Kerbal12/DatumLogic/Data Logger Report.pdf

# ESP32-Based Environmental Data Logger with IoT Control and Cloud Backup

## REPORT

Prepared by: Abhijith R, Adnan Nizam, Jensen Jose Sajan Date: 10/07/25

## 1. Abstract

This project presents an ESP32-based environmental data logger capable of real-time monitoring, automated control, and IoT-enabled remote access. It supports measurement of temperature, humidity, soil moisture, pressure, and light intensity and stores this data locally and on the cloud. The system integrates with Google Sheets and the Blynk platform for visualisation and remote control. Dual connectivity modes, utilising both WiFi and GSM, ensure continuous operation. Designed with scalability and reliability in mind, this device is suited for agriculture, research, and smart environment applications.

## 2. Introduction

The report provides the design and development of a real-time monitoring and control ESP32-based environmental data logger for environmental parameters. The system is suitable for use in agriculture, horticulture, and environmental studies and has automated control, robust local and cloud data logging, and complete remote access through IoT integration.

Objectives

- Measure temperature, humidity, soil moisture, atmospheric pressure, and light intensity.
- Record environmental data locally on a microSD card.
- Transfer sensor data to Google Sheets over the internet.
- Control connected devices automatically (e.g., pump, grow light) using sensor data.
- Allow remote monitoring and control through the Blynk IoT platform.
- Offer network redundancy by supporting WiFi and GSM-based data transmission.

System Overview

The data logger utilises the ESP32 microcontroller to acquire sensor readings at specified intervals. Data is shown locally, saved to an SD card, and uploaded to the cloud via WiFi or GSM (SIM800L). A real-time clock module stamps each reading. Both manual and automatic control of actuators through relay modules are supported by the system. Threshold values and operating modes can be set through the Blynk mobile app. The hardware assembly is enclosed in a custom 3D-printed case, designed for durability, sensor accessibility, and protection in semi-outdoor environments.

## 3. Project and System Details

### 3.1 Sensor Integration

- Temperature and Humidity Monitoring (DHT22)
- Soil Moisture Detection (Analog Sensor)
- Atmospheric Pressure Measurement (BMP180)
- Light Intensity Measurement (BH1750)

### 3.2 Data Logging

- Data is stored in CSV format on a microSD card.
- Cloud logging is performed via Google Sheets using HTTPS.
- Logging intervals are user-adjustable via the Blynk app.

Cloud logging in google sheets

### 3.3 Automated Control

- Automatic pump operation when soil moisture falls below a user-configured threshold.
- Grow light operations based on light intensity.
- Thresholds and automation modes are remotely configurable.
- Both relays have manual override.

### 3.4 Connectivity

- WiFi is the main network interface.
- GSM (SIM800L) as a failover if WiFi is not available.

- WiFiManager for dynamic WiFi credential configuration without code change.

### 3.5 User Interface

- The OLED display cycles through system status and sensor readings.
- Two buttons offer UI navigation and system reset.
- LED indicators indicate operation and connectivity status.

### 3.6 Software Architecture

The software is written based on the Arduino platform. It has a modular design for maintainability and readability. The most important tasks are allocated logically and make use of FreeRTOS where necessary for simultaneous/parallel execution.

### 3.6.1 Functional Modules

- Sensor reading and verification
- OLED display refresh and navigation
- SD card logging
- WiFi and GSM communication
- Blynk IoT interface
- Relay control logic
- Buck converter
- REAL Time Clock for time stamping (DS3231)

### 3.6.2 Cloud Integration

- Google Sheets receives data through HTTP POST requests via a Google Apps Script endpoint.
- The format consists of timestamp, temperature, humidity, soil moisture, light intensity, and pressure.
- Data is transmitted at configurable intervals with fallback logic to retry on failure.

### 3.7 Blynk IoT Platform

Real-time access to all sensor data and control commands for relays is provided through the Blynk app. The features include:

- Displaying live readings
- Specifying moisture and lux thresholds
- Enabling/disabling automation
- Toggling relays manually
- Adjusting logging intervals
- Forcing manual data uploads

### 3.8 Backup and Fail-Safes

For added system reliability, there are a number of fail-safes implemented:

### 3.8.1 SD Card Logging Backup

- When primary logging to the main CSV file is impossible, data is diverted to a temporary file on the same SD card.
- Logging resumes to the main file as soon as the problem is corrected.

### 3.8.2 Network Fallback

- The system tries to send data over WiFi initially.
- In case of failure to send via WiFi after a number of attempts, GSM is automatically set up and utilised to send data.

### 3.8.3 Logging Continuity

- Even if both cloud methods are not available, local logging proceeds uninterrupted.
- This prevents data loss even in poor network conditions.

### 3.8.4 System Recovery

- System or WiFi credentials can be reset with the help of buttons to reconfigure.
- All the errors and fallbacks are non-blocking and enable uninterrupted operation.

### 3.9 Operational Workflow

Startup:

- Initialises sensors, SD card, display, and connectivity modules.
- RTC time is verified and synchronised as required.

Loop Operation:

- Read all the sensors at the specified interval.
- Updates OLED display based on button interaction.
- Applies automation logic to control relays.
- Logs data to SD card.
- Sends data to Google Sheets via WiFi or GSM.
- Updates values to Blynk.

Manual Functions:

- Relay control and threshold changes via Blynk.
- Force logging and reset via button combinations.

### 3.10 Applications

- Precision Agriculture
- Greenhouse Automation
- Weather Station
- Remote Environmental Monitoring
- Educational and Research Projects

### 3.11 Images

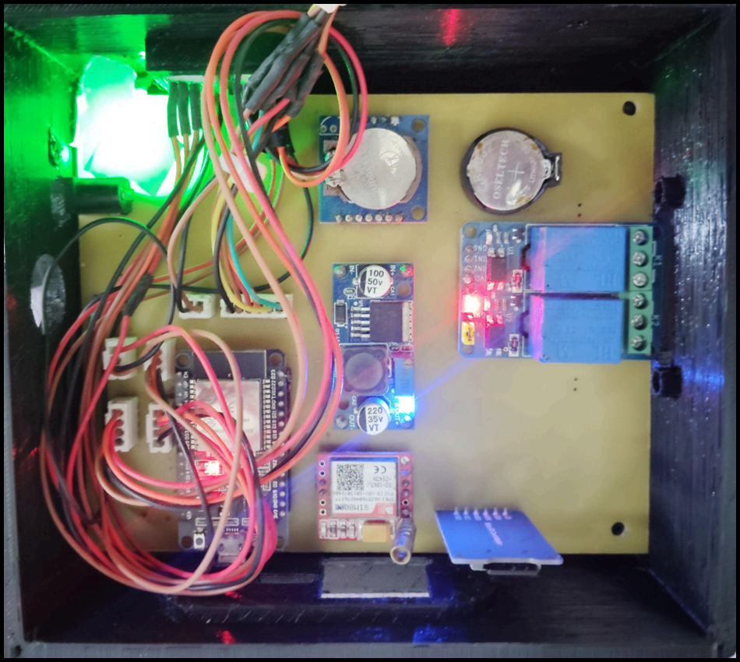
[picture p1: figure]

MAIN PCB

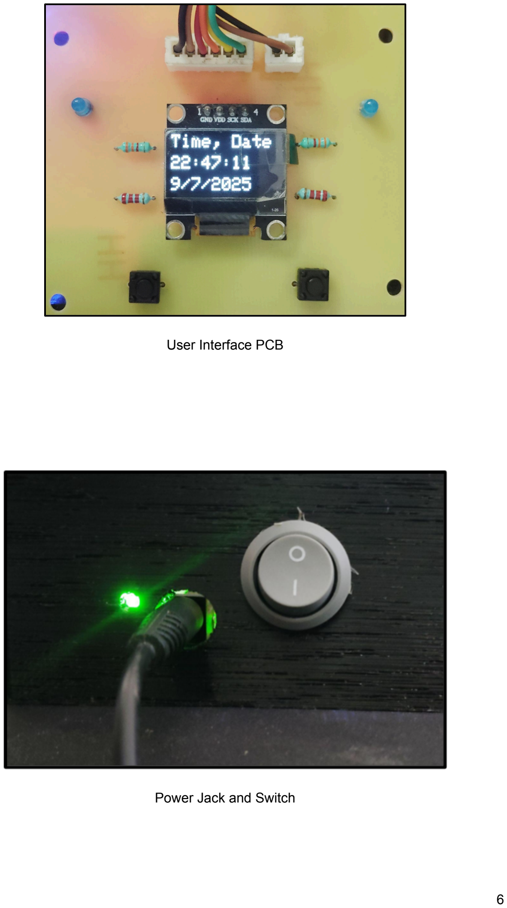
[picture p2: page 6]

User Interface PCB

Power Jack and Switch

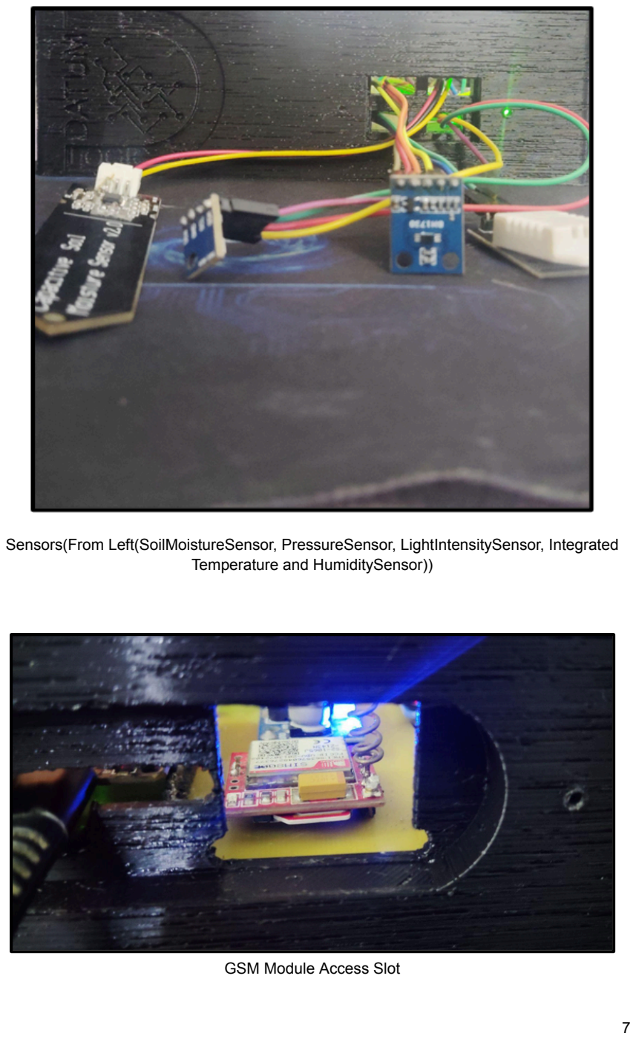
[picture p3: page 7]

Sensors(From Left(SoilMoistureSensor, PressureSensor, LightIntensitySensor, Integrated Temperature and HumiditySensor))

GSM Module Access Slot

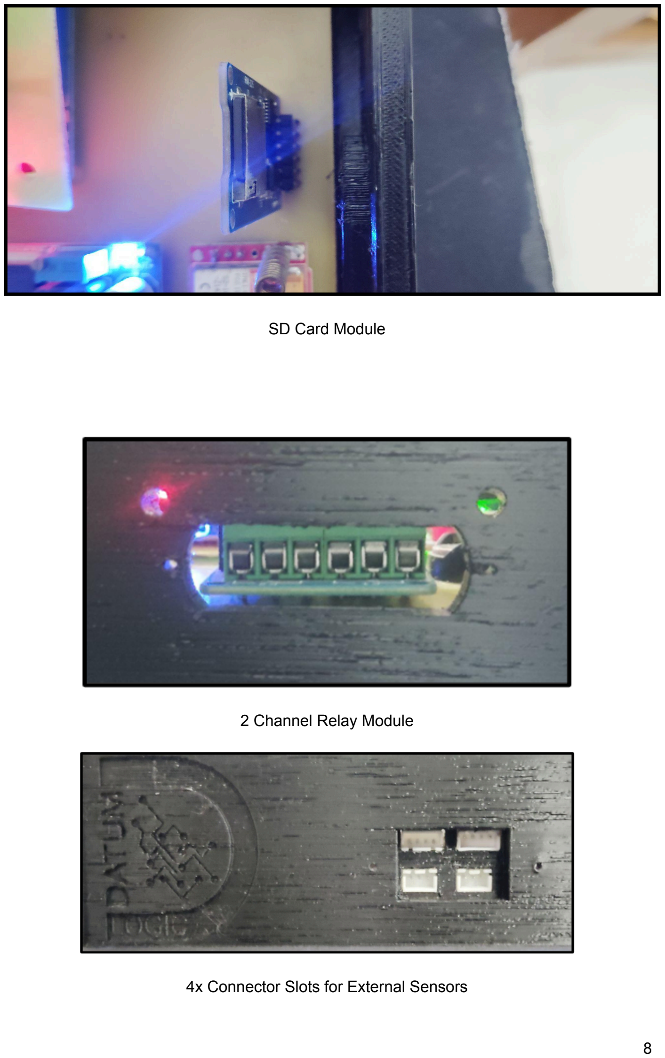
[picture p4: page 8]

SD Card Module

2 Channel Relay Module

4x Connector Slots for External Sensors

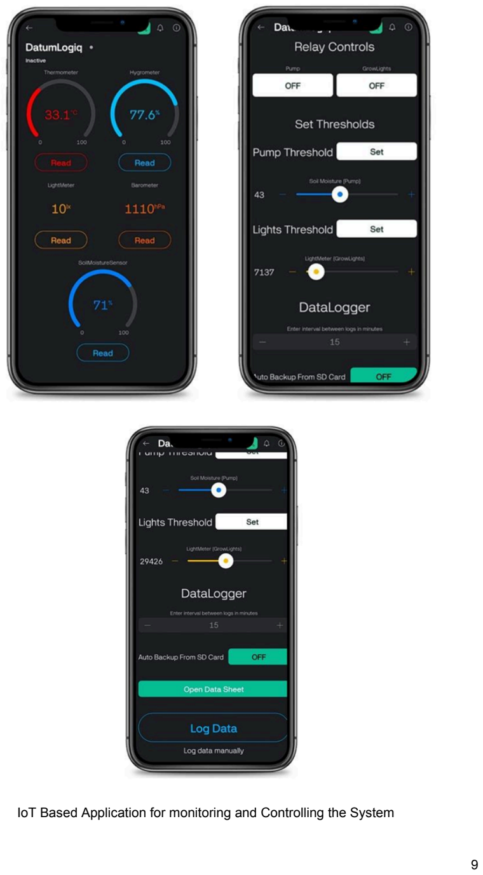
[picture p5: page 9]

IoT Based Application for monitoring and Controlling the System

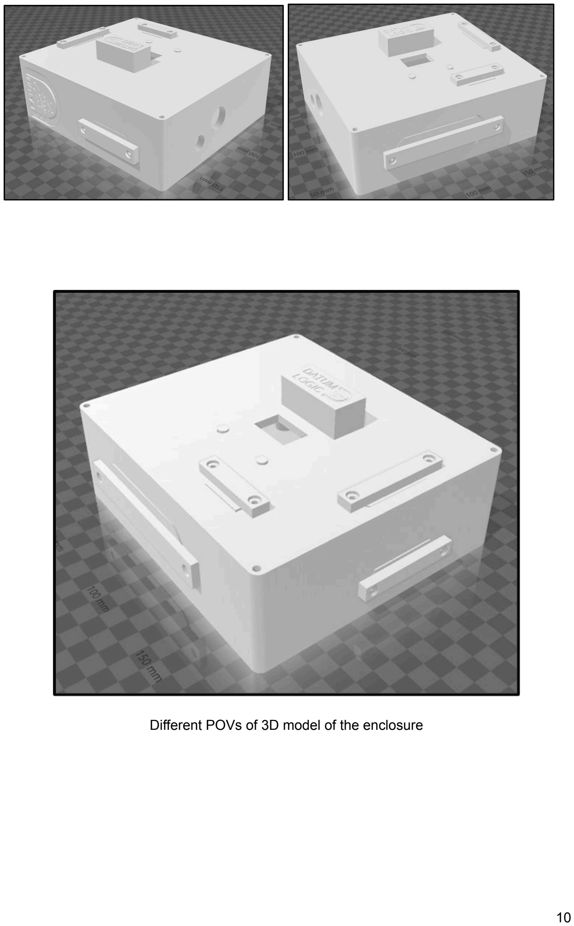
[picture p6: page 10]

Different POVs of 3D model of the enclosure

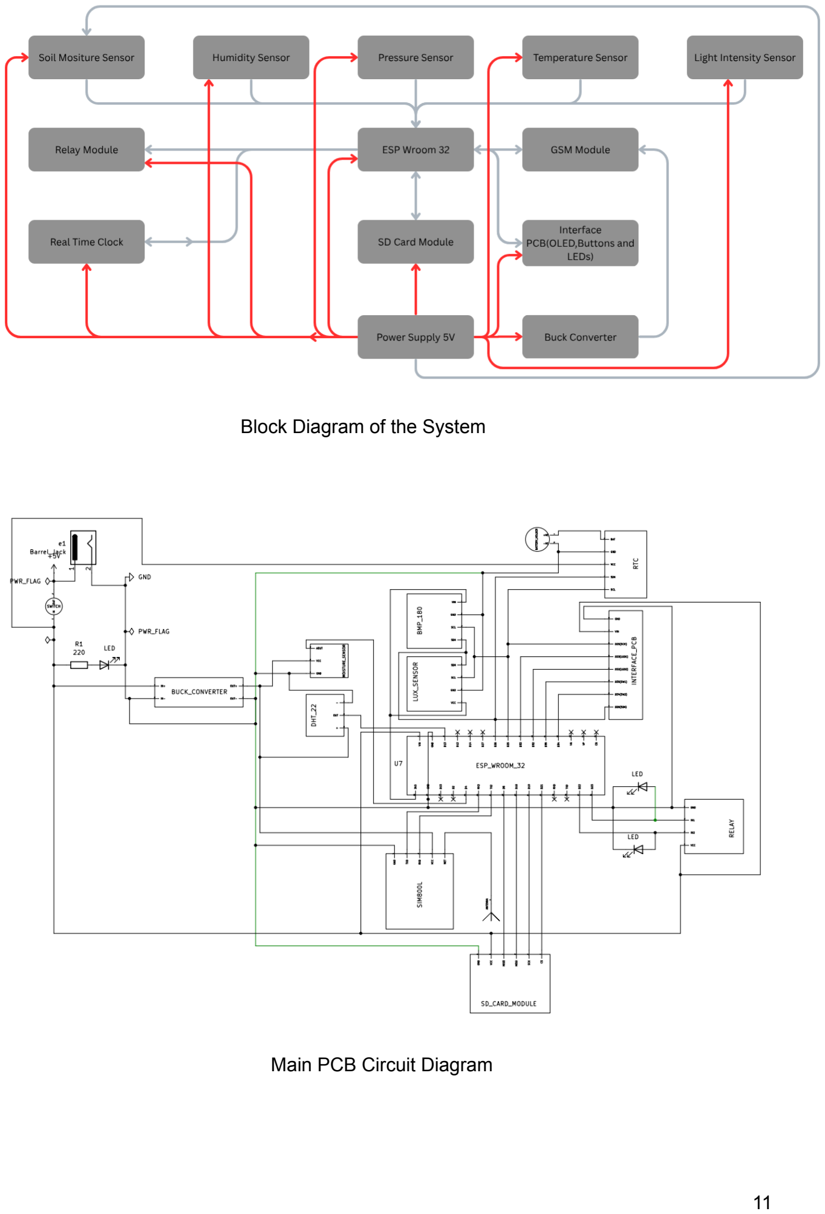
[picture p7: page 11]

Block Diagram of the System

Main PCB Circuit Diagram

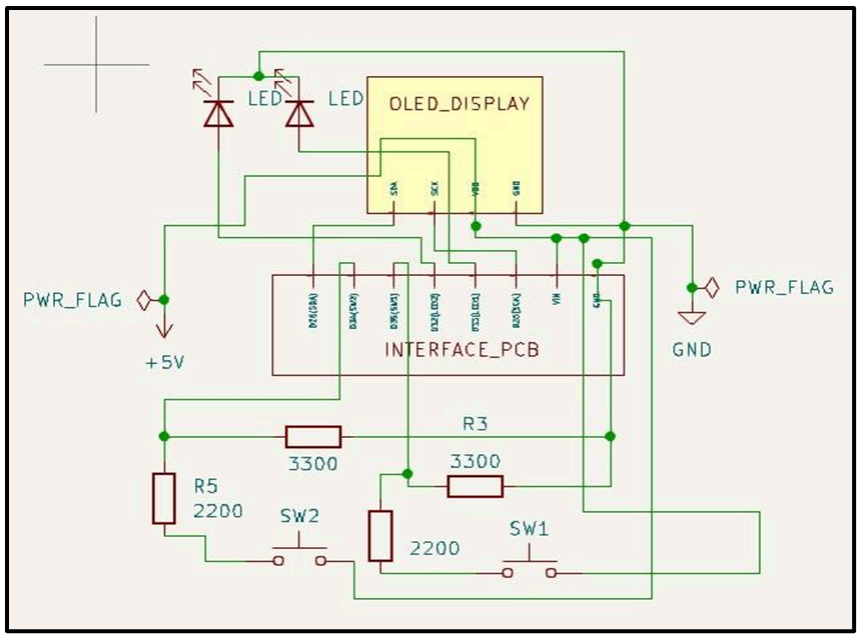
[picture p8: figure]

Interface PCB Circuit Diagram

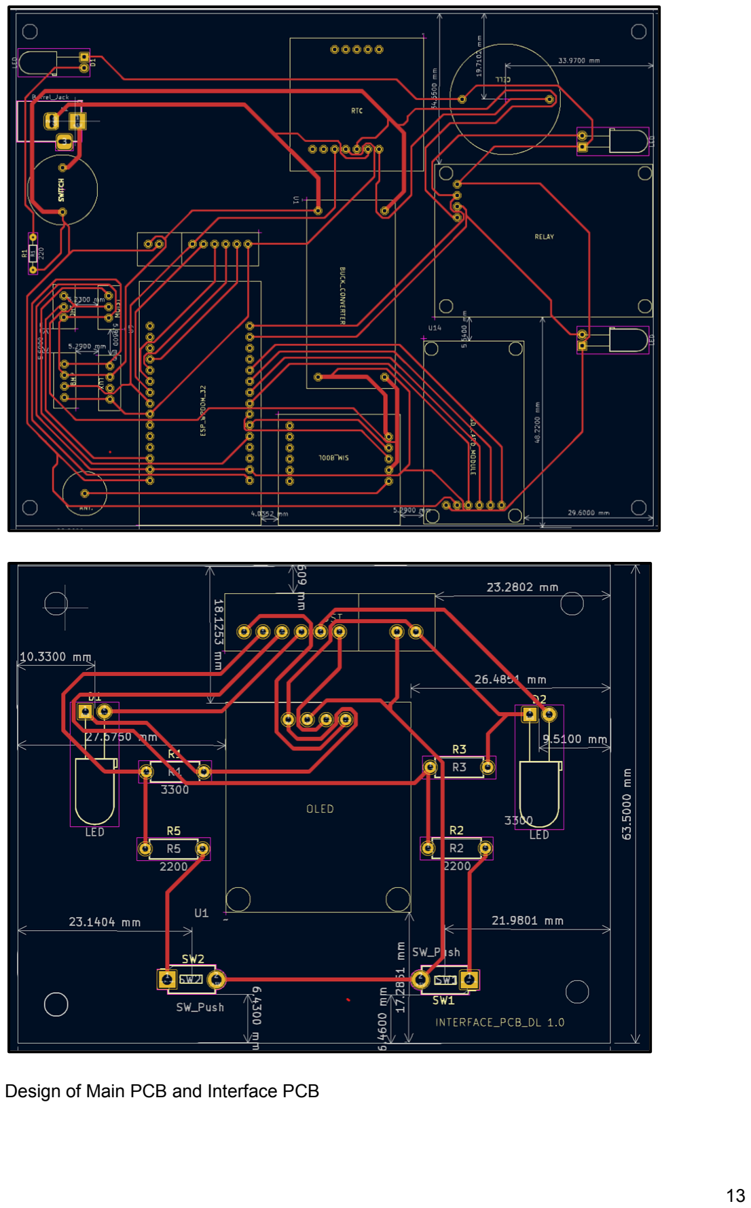
[picture p9: page 13]

Design of Main PCB and Interface PCB

## 4.Final Product Image

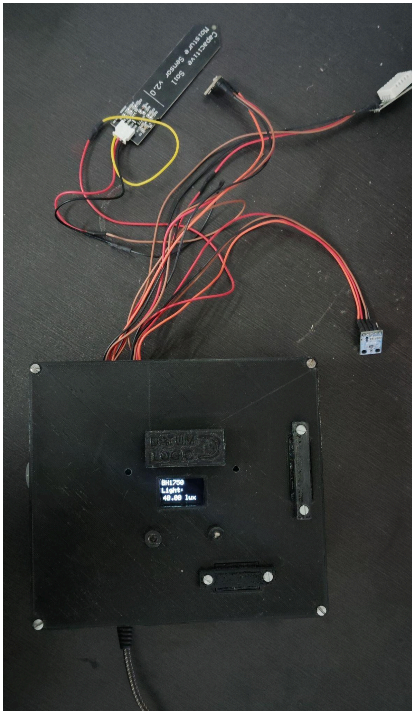
[picture p10: figure]

## 5.Test Results

The following tests were conducted to verify the system's core functionalities:

1. Automation Logic: Pump and light triggers responded correctly to threshold values.
2. Network Fallback: Verified GSM takeover when WiFi was disabled.
3. Cloud Logging: Data correctly reflected on Google Sheets with expected intervals.
4. SD Backup: Local logs maintained even when internet connectivity was lost.
5. Blynk app: Real-time access to all sensor data is provided through the Blynk app.

These results confirm the system operates reliably under varying environmental and network conditions.

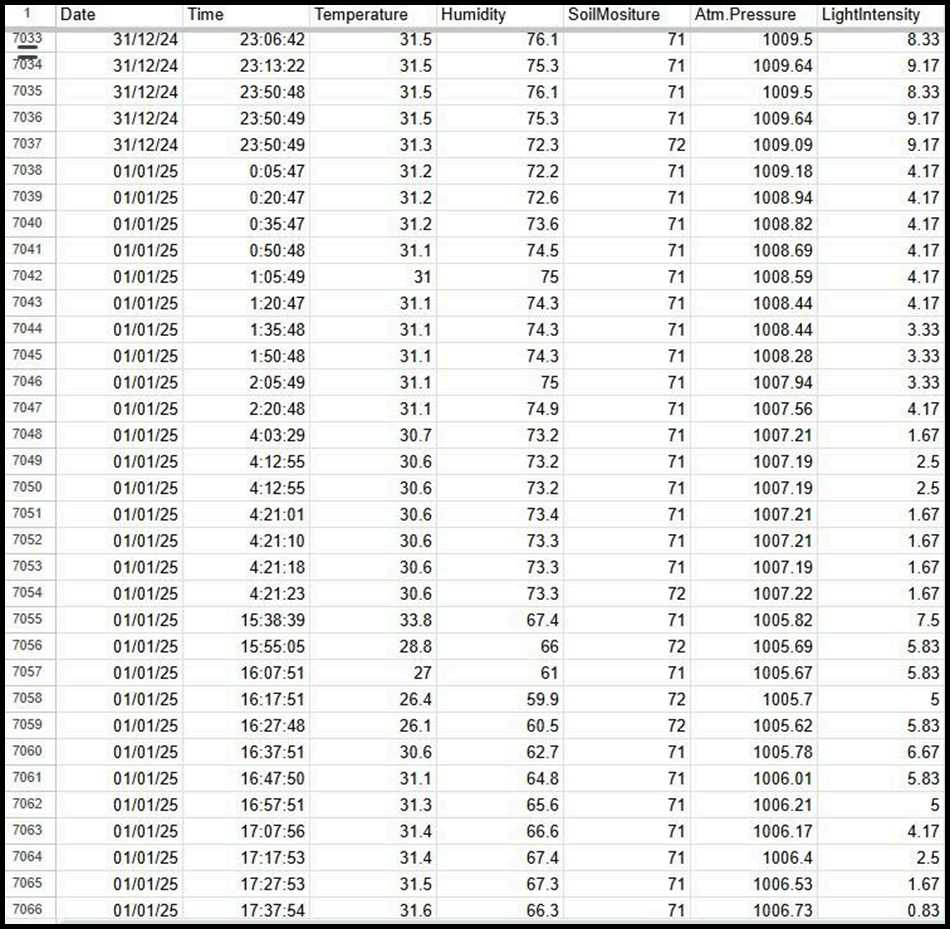
[picture p11: figure]

Sample of Data Logged to the Cloud

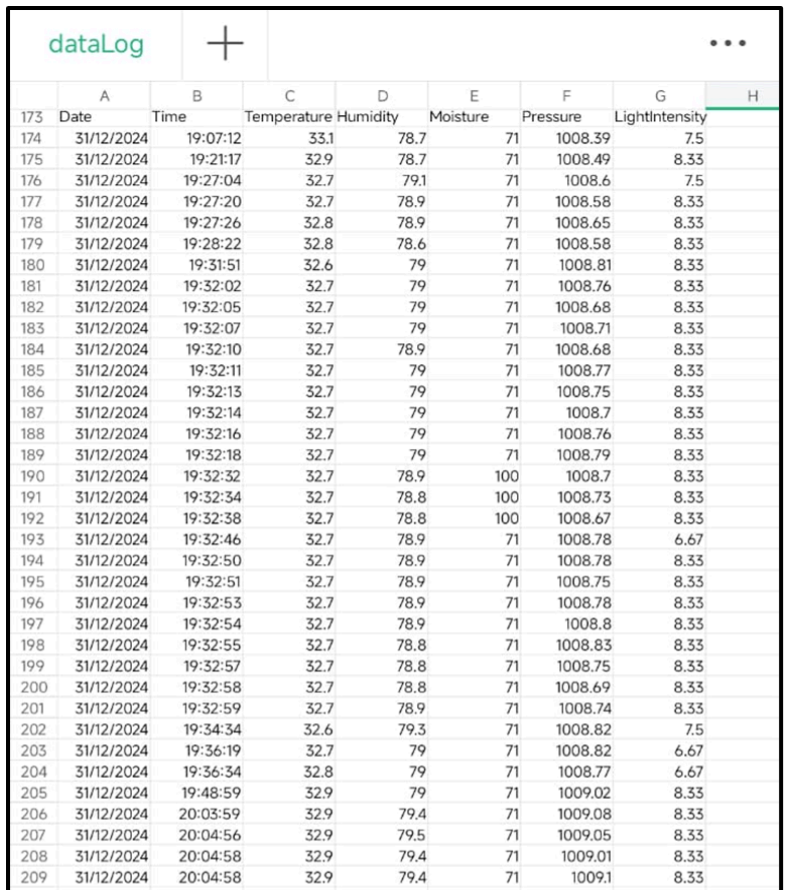
[picture p12: figure]

Sample of Data Logged Locally

## 6.Conclusion

The ESP32-based environmental data logger is a high-featured, robust, and scalable solution for real-time monitoring and automated control. With dual-mode network support, strong local logging, and complete IoT integration, the system guarantees continuous operation and accessibility. Its modular design and remote configurability make it perfectly suited to various real-world applications.

## 7.References

- Espressif Systems. "ESP32 Technical Reference Manual." https://docs.espressif.com
- Blynk IoT Platform Documentation. https://docs.blynk.io
- Google Apps Script Guides. "Web Apps." https://developers.google.com/apps-script/guides/web
